tynix5/echo_locate/hardware/v2.0/echo_locate.kicad_sch

## KiCad design hardware/v2.0/echo_locate.kicad_sch (2026-01-02)

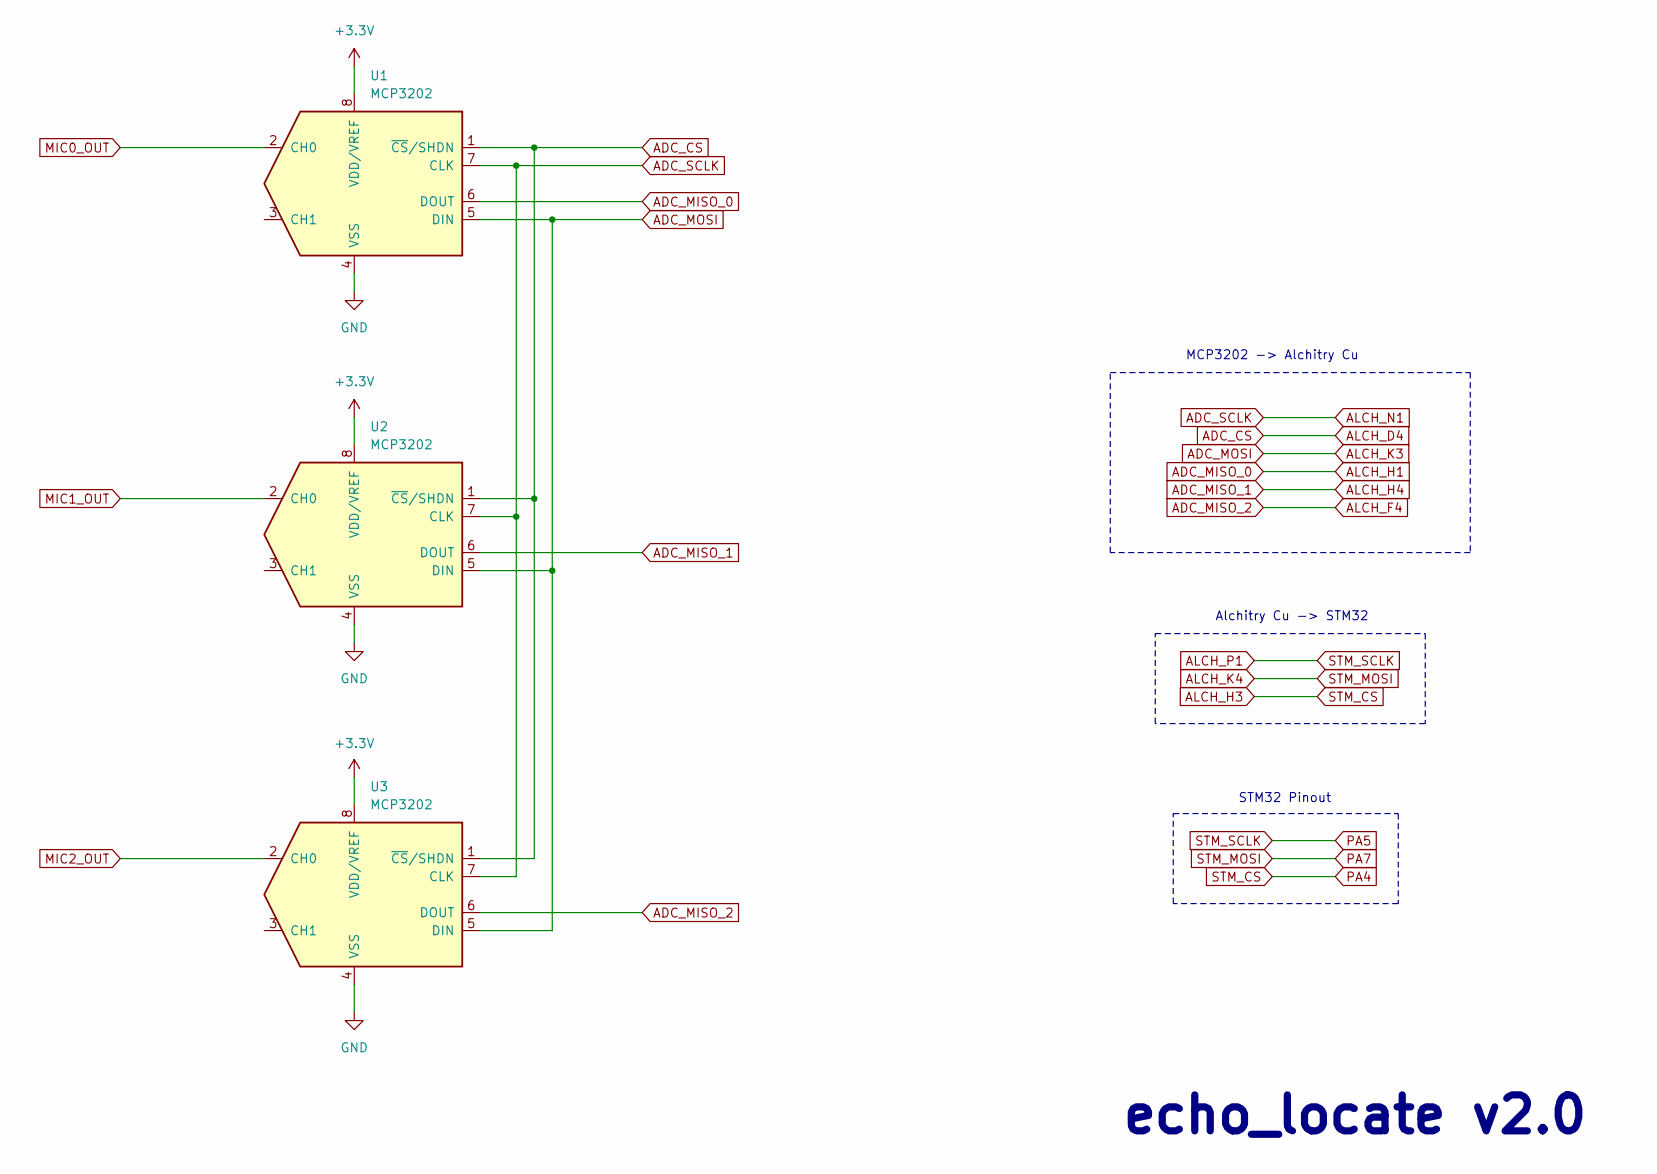
[picture p4: schematic echo_locate.kicad_sch]

Parts:
U1, U2, U3: MCP3202

Connections:
+3.3V: U1.8 (VDD/VREF), U2.8 (VDD/VREF), U3.8 (VDD/VREF)
ADC_CS: U1.1 (~CS/SHDN), U2.1 (~CS/SHDN), U3.1 (~CS/SHDN)
ADC_MISO_0: U1.6 (DOUT)
ADC_MISO_1: U2.6 (DOUT)
ADC_MISO_2: U3.6 (DOUT)
ADC_MOSI: U1.5 (DIN), U2.5 (DIN), U3.5 (DIN)
ADC_SCLK: U1.7 (CLK), U2.7 (CLK), U3.7 (CLK)
GND: U1.4 (VSS), U2.4 (VSS), U3.4 (VSS)
MIC0_OUT: U1.2 (CH0)
MIC1_OUT: U2.2 (CH0)
MIC2_OUT: U3.2 (CH0)

Notes on the sheet:
echo_locate v2.0
Alchitry Cu -> STM32
STM32 Pinout
MCP3202 -> Alchitry Cu
