tynix5/echo_locate/(commit log)

2025-07-28 DMA with single ADC channel and FIR
2025-08-08 Decreased FIR filter time using q15_t types and WIP calculate position from 3 timestamps
2025-09-05 Plotting points on Python. Relative positions correct, exact positions are wrong. Added a block diagram
    [plotter.py]
2025-09-20 Calculated positions within 10-15 cm of actual positions. Need to decrease decimation factor or use interpolation for increasing accuracy
2025-11-12 Updated block diagram and added comments in main. Ran additional tests on bandpass filter
2025-12-20 Developed and simulated simultaneous ADC sampling. Updated READMEs. Need to update .pcf
2025-12-26 Modified FPGA to send three consecutive 16-bit streams to STM32. Modified STM32 to support DMA for SPI1
2025-12-30 Modified MCP3202 SPI to transfer 17 bits for ADC sample
2026-01-02 Updated noise threshold to update after N consecutive quiet windows. Could try using energy threshold instead of mean + std dev but this works well
    [tdoa_plotter.py]
2026-01-02 Updated READMEs and added new block diagram
    [echo_locate.kicad_pcb, echo_locate.kicad_sch]
